OpenSprinkler/OSBeeWiFi-Hardware/README.md

## OpenSprinkler Bee WiFi Eagle Files

This folder contains EagleCAD schematic and board design files for OpenSprinkler Bee WiFi circuit. Please use EagleCAD 7.0 or above to view the files. We generally do not provide BOM, but you can use EagleCAD's BOM script to export a BOM yourself.
