OpenSprinkler/OSBeeWiFi-Hardware/v2.0/README.md

OpenSprinkler Bee 2.0 Pin Assignments:
===================

- GPIO0:  Button
- GPIO2:  COM 
- GPIO4:  SDA
- GPIO5:  SCL
- GPIO12: Z1
- GPIO13: Z2
- GPIO14: Z3
- GPIO15: BST Power  (High-side Switch 1)
- GPIO16: BST Enable (High-side Switch 2)
