OpenSprinkler/OSBeeWiFi-Hardware/v3.0/osbee_3.0.png

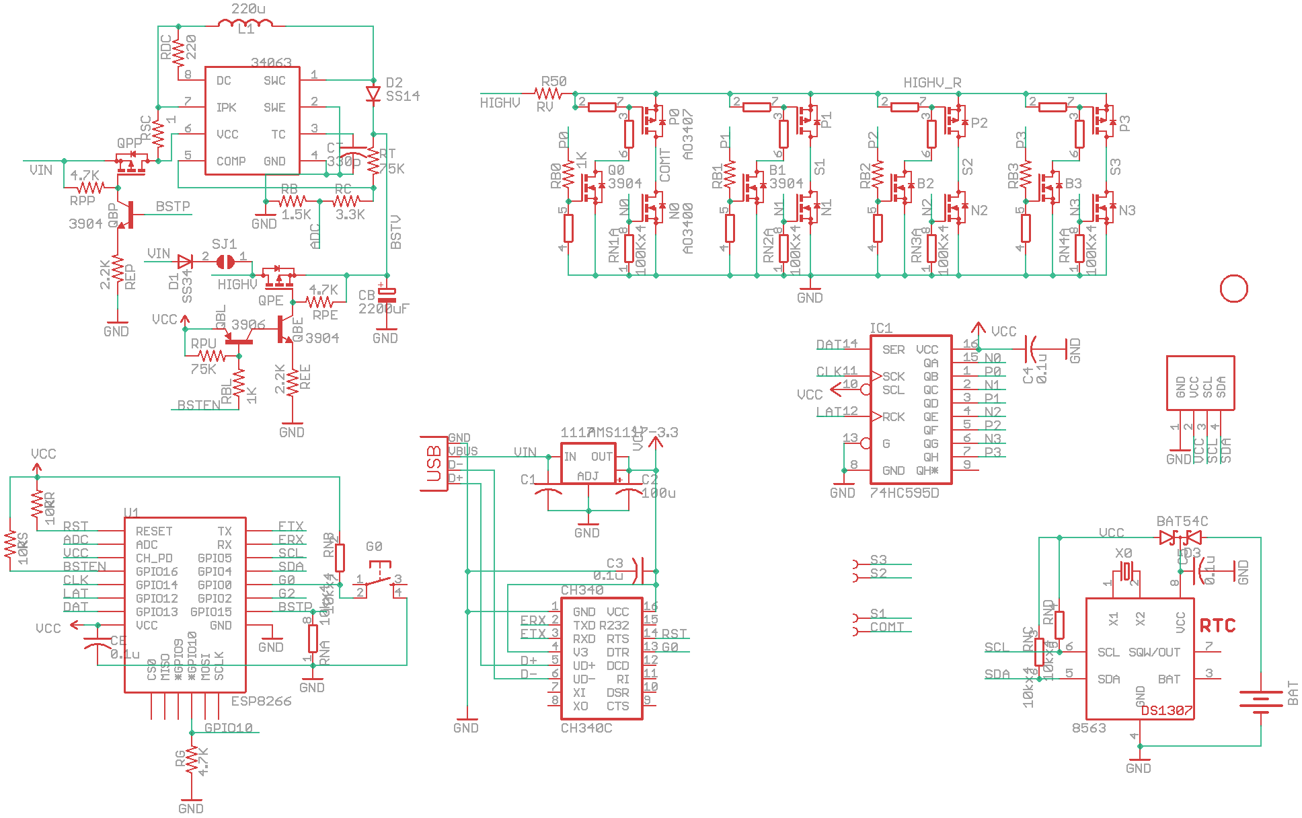
v3.0/osbee_3.0.png
