OpenSprinkler/OSBeeWiFi-Hardware/v3.0/OSBee3_enclosure.stl

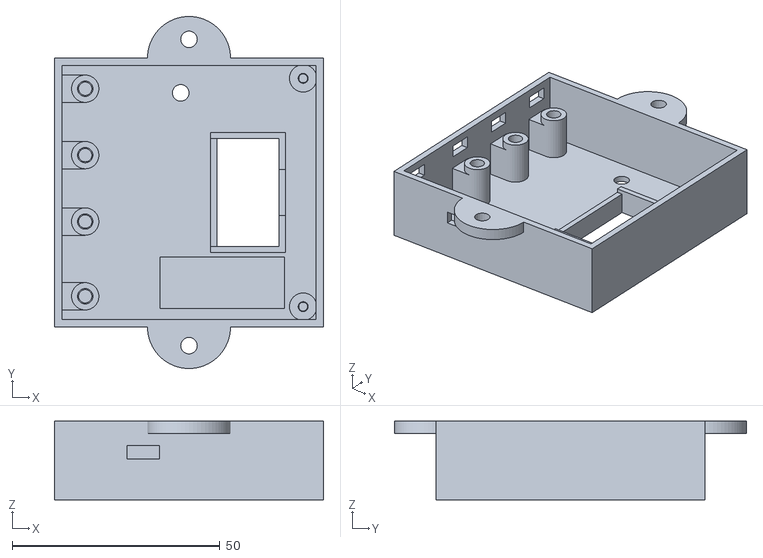
[picture p2: CAD file, 2023-06-05]
v3.0/OSBee3_enclosure.stl
64.8 x 84.8 x 19.0
