OpenSprinkler/OSBeeWiFi-Hardware/v3.0/osbee_3.0.brd

## EAGLE design v3.0/osbee_3.0.brd (2021-09-07)

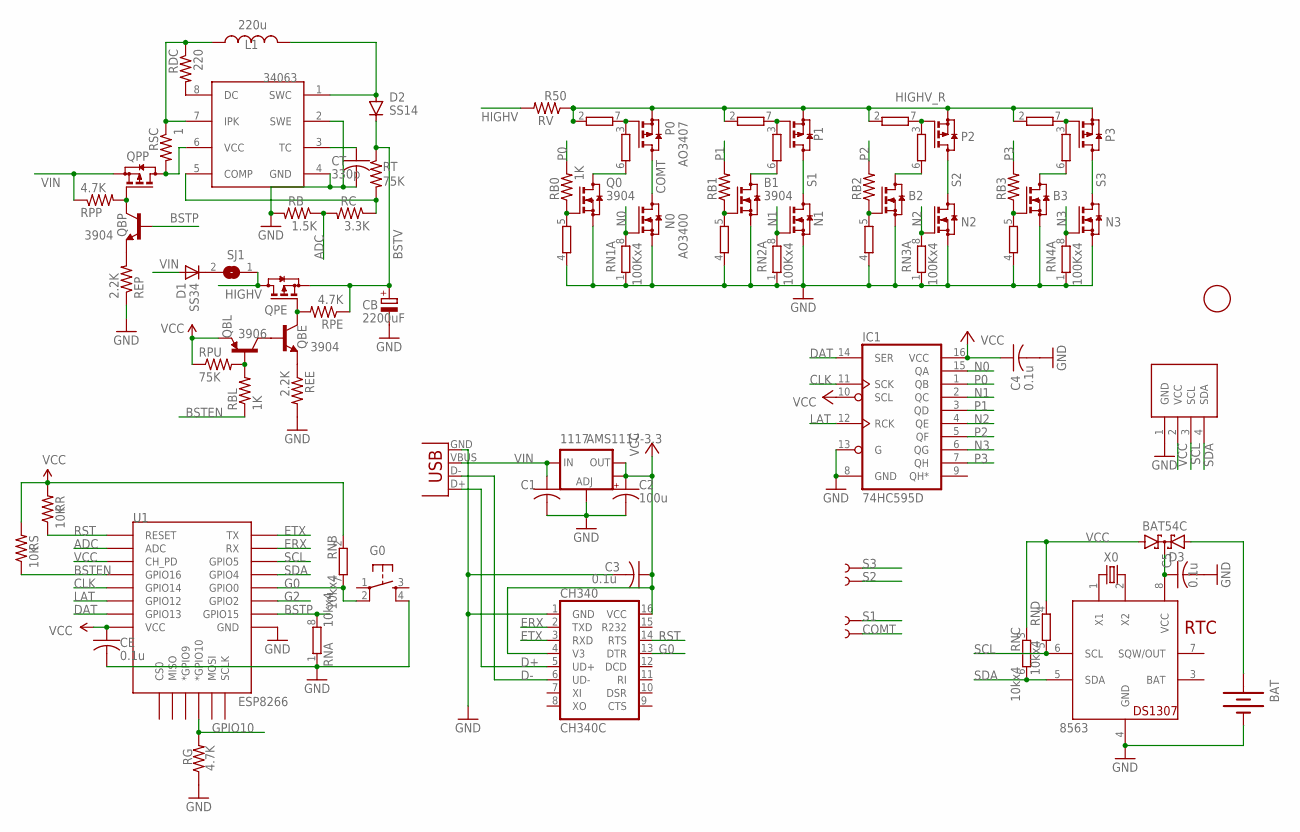
[picture p3: schematic osbee_3.0.sch]

Parts:
1F: FIDUCIAL; FIDUCIAL_1MM
1117: AMS1117-3.3; SOT223
8563: PCF8563; SO08
34063: MC34063; SO08
B1, B2, B3: 3904; SOT23
BAT: BATTERYBATTERY_12MM_SMT; BATTCON_12MM_SMT
C1: 10u; C0805K
C2: 100u; PANASONIC_C
C3: 0.1u; C0603K
C4, C5: 0.1u; C0603
CB: 2200uF; E5-8,5
CE: 0.1u; C0603
CH340: CH340C; SO16
CT: 330p; C0603K
D1: SS34; SMB-DIODE
D2: SS14; DO-214AC
D3: BAT54C; SOT23
G0: SPST_TACT; EVQ-Q2-SMD
IC1: 74HC595D; SO16
L1: 220u; CR54
N0, N1, N2, N3: AO3400; SOT23
P0, P1, P2, P3: AO3407; SOT23
Q0: 3904; SOT23
QBE: 3904; SOT23-3
QBL: 3906; SOT23-3
QBP: 3904; SOT23-3
QPE: AO3407; SOT23
QPP: AO3407; SOT23
RB: 1.5K; R0603
RB0, RB1, RB2, RB3: 1K; R0603
RBL: 1K; R0603
RC: 3.3K; R0603
RDC: 220; R0603
REE: 2.2K; R0603
REP: 2.2K; R0603
RG: 4.7K; R0603
RN: 10kx4; EXB38V
RN1, RN2, RN3, RN4: 100Kx4; EXB38V
RPE: 4.7K; R0603
RPP: 4.7K; R0603
RPU: 75K; R0603
RR: 10K; R0603
RS: 10K; R0603
RSC: 1; R0603
RT: 75K; R0603
RV: R50; R2512
SJ1: SJ
ST1, ST2, ST3: NOBOM-; PETAL-9X9
STT: NOBOM-; PETAL-9X9
U1: ESP8266; ESP12E-SMD
U$1: NOBOM-OLED; SSD1306_OLED_I2C_PCB_0.75_BNEW
USB: USBMICROB2; USB-MICROB2
X0: 32.768kHz; 3.2X1.5

Connections:
ADC: RB.1, RC.2, U1.ADC
BAT: 8563.3 (BAT)
BSTEN: RBL.1, RS.1, U1.GPIO16
BSTP: QBP.1 (B), RN.8 (2), U1.GPIO15
BSTV: CB.+, D2.C, QPE.2 (S), RPE.1, RT.1
CLK: IC1.11 (SCK), U1.GPIO14
COMT: N0.3 (D), P0.3 (D), STT.P$1
D+: CH340.5 (UD+), USB.D+
D-: CH340.6 (UD-), USB.D-
DAT: IC1.14 (SER), U1.GPIO13
ERX: CH340.2 (TXD), U1.RXD0 (RX)
ETX: CH340.3 (RXD), U1.TXD0 (TX)
G0: CH340.13 (DTR), G0.2, RN.7 (2), U1.GPIO0
G2: U1.GPIO2
GND: 1117.1 (ADJ), 8563.4 (GND), 34063.2 (SWE), 34063.4 (GND), B1.2 (S), B2.2 (S), B3.2 (S), BAT.P$1 (-), C1.2, C2.-, C3.2, C4.2, C5.2, CB.-, CE.2, CH340.1 (GND), CT.2, G0.4, IC1.8 (GND), IC1.13 (G), N0.2 (S), N1.2 (S), N2.2 (S), N3.2 (S), Q0.2 (S), RB.2, REE.2, REP.1, RG.1, RN.1, RN1.1, RN1.4 (1), RN2.1, RN2.4 (1), RN3.1, RN3.4 (1), RN4.1, RN4.4 (1), U1.GND, U$1.1 (GND), USB.GND
GPIO10: RG.2, U1.GPIO10 (*GPIO10)
HIGHV: QPE.3 (D), RV.2, SJ1.1
HIGHV_R: P0.2 (S), P1.2 (S), P2.2 (S), P3.2 (S), RN1.2 (1), RN2.2 (1), RN3.2 (1), RN4.2 (1), RV.1
LAT: IC1.12 (RCK), U1.GPIO12
N0: IC1.15 (QA), N0.1 (G), RN1.8 (2)
N1: IC1.2 (QC), N1.1 (G), RN2.8 (2)
N2: IC1.4 (QE), N2.1 (G), RN3.8 (2)
N3: IC1.6 (QG), N3.1 (G), RN4.8 (2)
unnamed: P0.1 (G), RN1.3 (1), RN1.7 (2)
unnamed: QBP.3 (C), QPP.1 (G), RPP.2
unnamed: Q0.3 (D), RN1.6 (2)
unnamed: B1.3 (D), RN2.6 (2)
unnamed: Q0.1 (G), RB0.1, RN1.5 (2)
unnamed: B3.1 (G), RB3.1, RN4.5 (2)
unnamed: P1.1 (G), RN2.3 (1), RN2.7 (2)
unnamed: B3.3 (D), RN4.6 (2)
unnamed: 34063.1 (SWC), D2.A, L1.P$2 (2)
unnamed: D1.C, SJ1.2
unnamed: BAT.P$2 (+), D3.2 (A2)
unnamed: P2.1 (G), RN3.3 (1), RN3.7 (2)
unnamed: B2.3 (D), RN3.6 (2)
unnamed: 8563.1 (X1), X0.1
unnamed: QBL.1 (B), RBL.2, RPU.2
unnamed: P3.1 (G), RN4.3 (1), RN4.7 (2)
unnamed: QBE.1 (B), QBL.3 (C)
unnamed: QBE.2 (E), REE.1
unnamed: B1.1 (G), RB1.1, RN2.5 (2)
unnamed: B2.1 (G), RB2.1, RN3.5 (2)
unnamed: 34063.7 (IPK), L1.P$1 (1), RDC.1, RSC.1
unnamed: 34063.6 (VCC), QPP.3 (D), RSC.2
unnamed: 34063.3 (TC), CT.1
unnamed: 34063.5 (COMP), RC.1, RT.2
unnamed: 8563.2 (X2), X0.2
unnamed: 34063.8 (DC), RDC.2
unnamed: QBP.2 (E), REP.2
unnamed: QBE.3 (C), QPE.1 (G), RPE.2
unnamed: 8563.8 (VCC), C5.1, D3.3 (CC)
P0: IC1.1 (QB), RB0.2
P1: IC1.3 (QD), RB1.2
P2: IC1.5 (QF), RB2.2
P3: IC1.7 (QH), RB3.2
RST: CH340.14 (RTS), RR.1, U1.RESET
S1: N1.3 (D), P1.3 (D), ST1.P$1
S2: N2.3 (D), P2.3 (D), ST2.P$1
S3: N3.3 (D), P3.3 (D), ST3.P$1
SCL: 8563.6 (SCL), RN.5 (2), U1.GPIO5, U$1.3 (SCL)
SDA: 8563.5 (SDA), RN.6 (2), U1.GPIO4, U$1.4 (SDA)
VCC: 1117.2 (OUT), 1117.4 (OUT), C2.+, C3.1, C4.1, CE.1, CH340.4 (V3), CH340.16 (VCC), D3.1 (A1), IC1.10 (SCL), IC1.16 (VCC), QBL.2 (E), RN.2 (1), RN.3 (1), RN.4 (1), RPU.1, RR.2, RS.2, U1.CH_PD, U1.VCC, U$1.2 (VCC)
VIN: 1117.3 (IN), C1.1, D1.A, QPP.2 (S), RPP.1, USB.VBUS

Notes on the sheet:
RTC

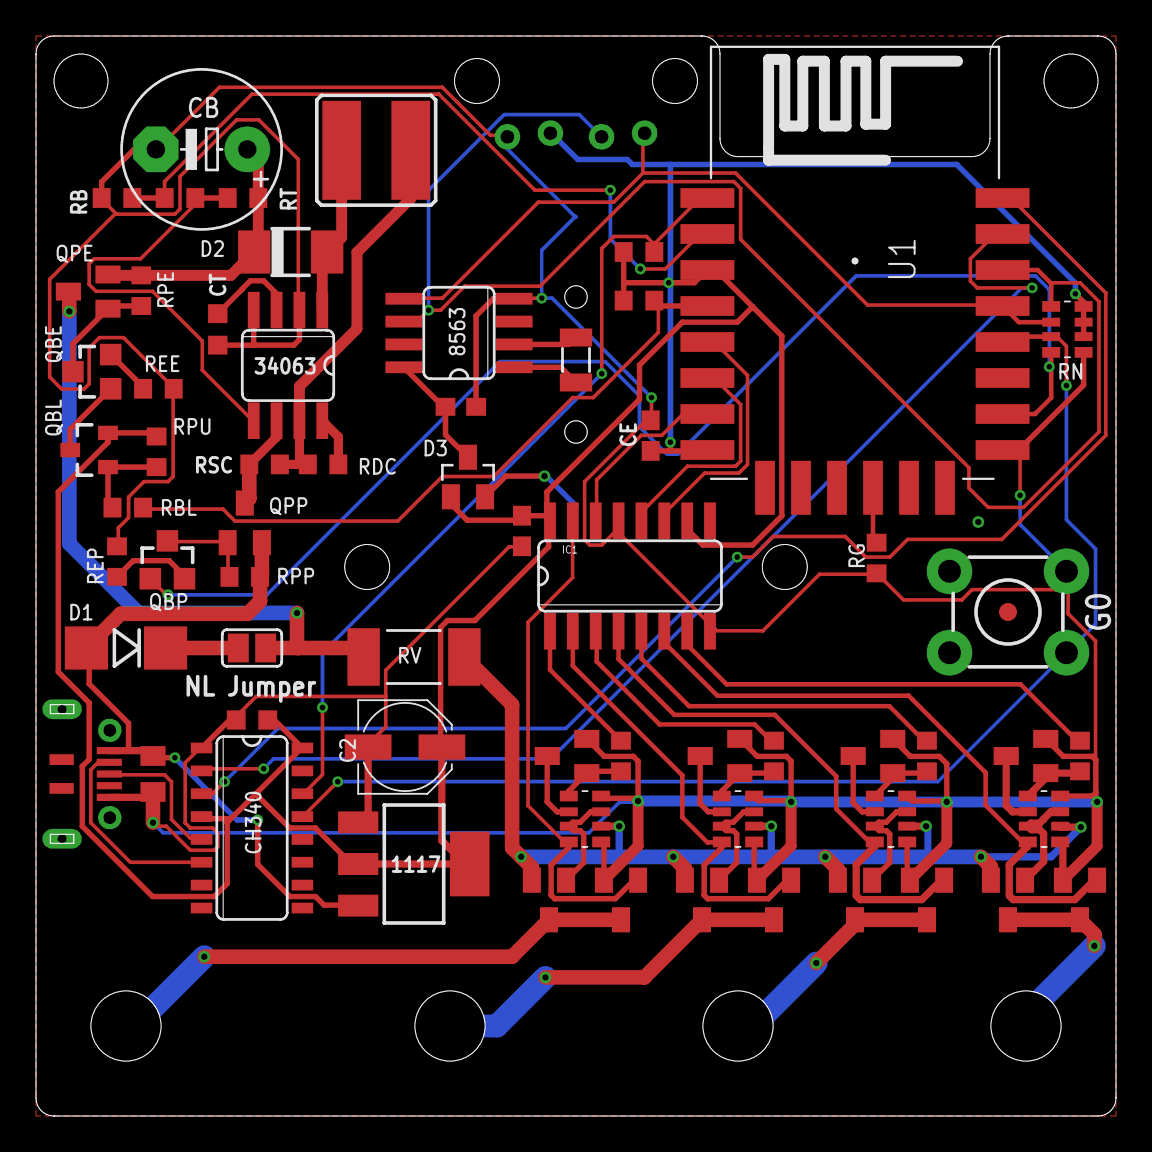
[picture p4: board osbee_3.0.brd from above]

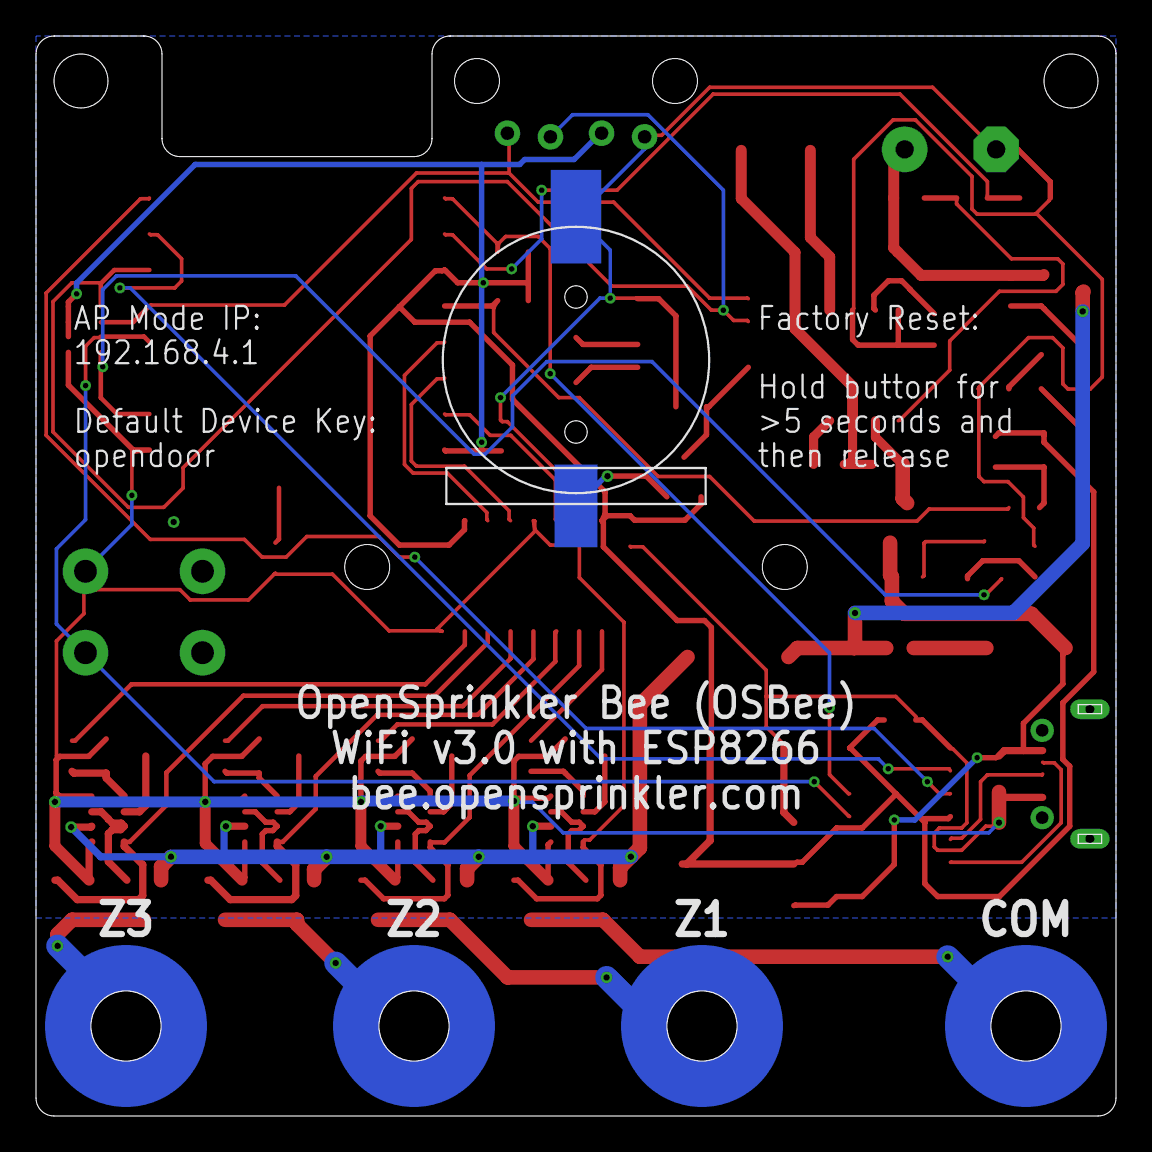
[picture p5: board osbee_3.0.brd from below]

Board: 2 copper layers, 60.0 x 60.0 mm, 70 parts (5 on the bottom side), 62 nets.
