OpenSprinkler/OSBeeWiFi-Hardware/v2.0/osbwifi20.brd

## EAGLE design v2.0/osbwifi20.brd (2016-12-05, an earlier design)

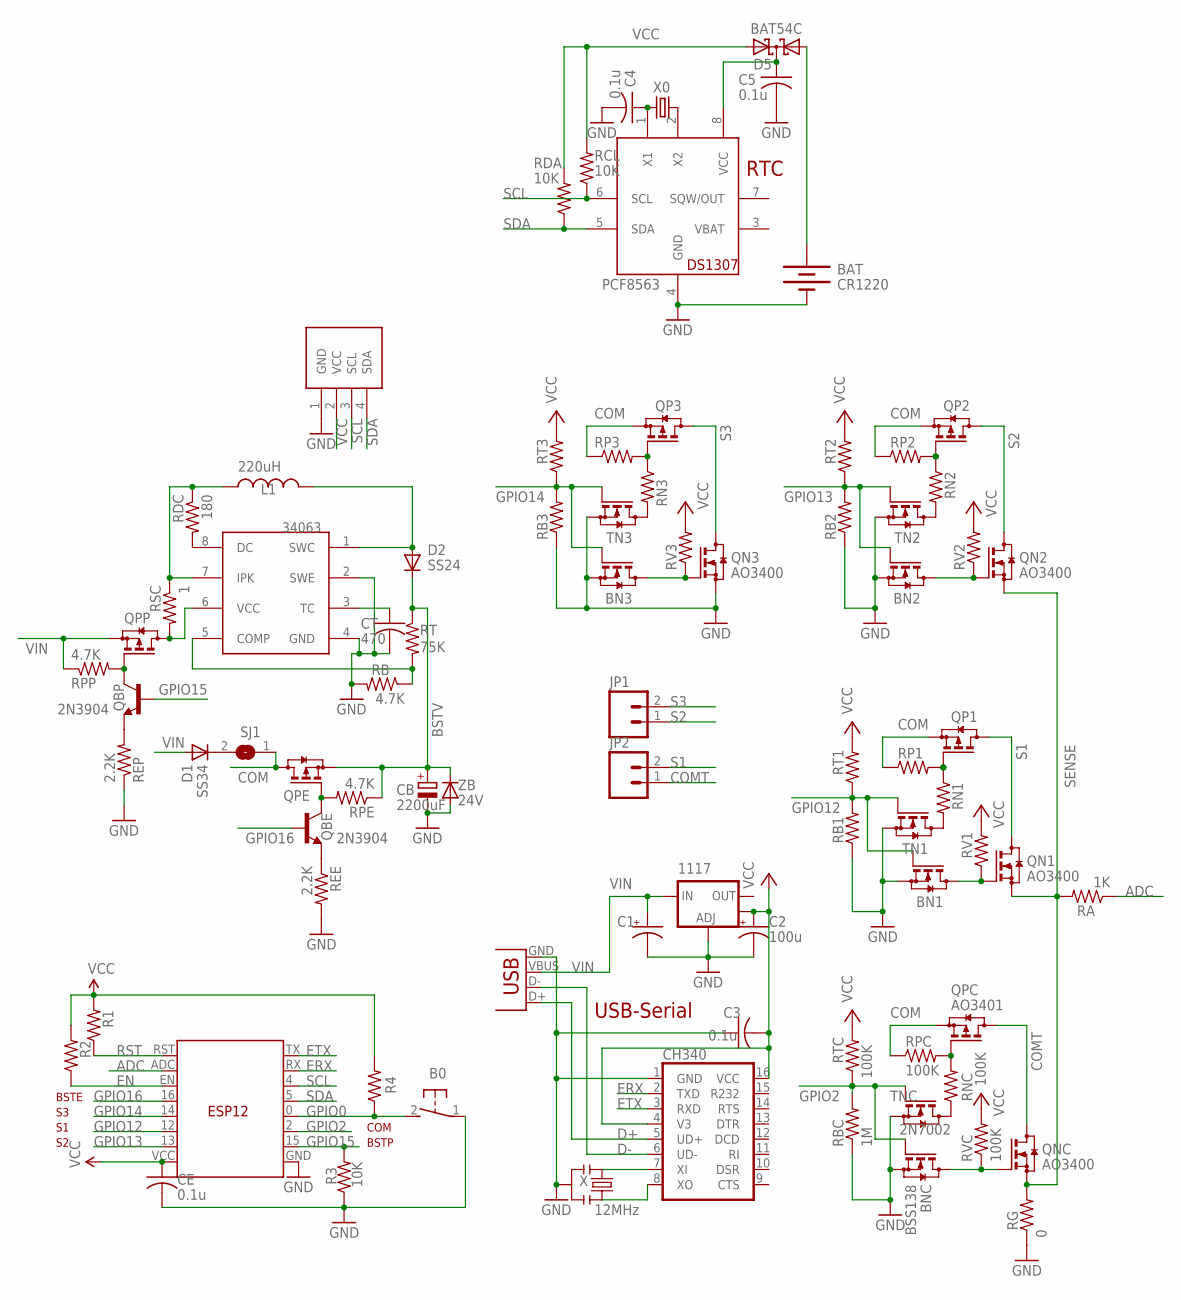
[picture p6: schematic osbwifi20.sch]

Parts:
1117: 1117; SOT223
34063: MC33063/MC34063D; SO08
B0: 31-XX; B3F-31XX
BAT: CR1220; BATTCON_12MM_SMT
BN1, BN2, BN3: BSS138; SOT23
BNC: BSS138; SOT23
C1, C2: 100u; B/3528-21R
C3, C4, C5: 0.1u; C0603
CB: 2200uF; E5-8,5
CE: 0.1u; C0603
CH340: CH340G; SO16
CT: 470; C0603K
D1: SS34; SMB
D2: SS24; DO-214AC
D5: BAT54C; SOT23
ESP: ESP; ESP12
JP1, JP2: M025MM; SCREWTERMINAL-5MM-2
L1: 220uH; CR54
PCF8563: PCF8563; SO08
QBE: 2N3904; SOT23-3
QBP: 2N3904; SOT23-3
QN1, QN2, QN3: AO3400; SOT23
QNC: AO3400; SOT23
QP1, QP2, QP3: AO3407; SOT23
QPC: AO3401; SOT23
QPE: AO3401; SOT23
QPP: AO3401; SOT23
R1, R2, R3, R4: 10K; R0603
RA: 1K; R0603
RB: 4.7K; R0603
RB1, RB2, RB3: 1M; R0603
RBC: 1M; R0603
RCL: 10K; R0603
RDA: 10K; R0603
RDC: 180; R0603
REE: 2.2K; R0603
REP: 2.2K; R0603
RG: 0; R2512
RN1, RN2, RN3: 100K; R0603
RNC: 100K; R0603
RP1, RP2, RP3: 100K; R0603
RPC: 100K; R0603
RPE: 4.7K; R0603
RPP: 4.7K; R0603
RSC: 1; R0603
RT: 75K; R0603
RT1, RT2, RT3: 100K; R0603
RTC: 100K; R0603
RV1, RV2, RV3: 100K; R0603
RVC: 100K; R0603
SJ1: SJ
TN1, TN2, TN3: 7002; SOT23
TNC: 2N7002; SOT23
U$1: SSD1306_OLED_I2C
USB: USBSMD; USB-MINIB
X: 12MHz; RESONATOR-SMD
X0: 32.768kHz; MM20SS1
ZB: 24V; MINIMELF

Connections:
ADC: ESP.ADC, RA.1
BSTV: CB.+, D2.C, QPE.2 (S), RPE.1, RT.1, ZB.C
COM: QP1.2 (S), QP2.2 (S), QP3.2 (S), QPC.2 (S), QPE.3 (D), RP1.1, RP2.1, RP3.1, RPC.1, SJ1.1
COMT: JP2.1, QNC.3 (D), QPC.3 (D)
D+: CH340.5 (UD+), USB.D+
D-: CH340.6 (UD-), USB.D-
EN: ESP.EN, R2.1
ERX: CH340.2 (TXD), ESP.RX
ETX: CH340.3 (RXD), ESP.TX
GND: 1117.1 (ADJ), 34063.2 (SWE), 34063.4 (GND), B0.1, BAT.P$1 (-), BN1.2 (S), BN2.2 (S), BN3.2 (S), BNC.2 (S), C1.-, C2.-, C3.1, C4.2, C5.2, CB.-, CE.2, CH340.1 (GND), CT.2, ESP.GND, PCF8563.4 (GND), QN3.2 (S), R3.1, RB.2, RB1.1, RB2.1, RB3.1, RBC.1, REE.2, REP.1, RG.1, TN1.2 (S), TN2.2 (S), TN3.2 (S), TNC.2 (S), U$1.1 (GND), USB.GND, X.2, ZB.A
GPIO0: B0.2 (S), ESP.0 (G0), R4.1
GPIO2: BNC.1 (G), ESP.2 (G2), RBC.2, RTC.1, TNC.1 (G)
GPIO12: BN1.1 (G), ESP.12 (G12), RB1.2, RT1.1, TN1.1 (G)
GPIO13: BN2.1 (G), ESP.13 (G13), RB2.2, RT2.1, TN2.1 (G)
GPIO14: BN3.1 (G), ESP.14 (G14), RB3.2, RT3.1, TN3.1 (G)
GPIO15: ESP.15 (G15), QBP.1 (B), R3.2
GPIO16: ESP.16 (G16), QBE.1 (B)
unnamed: QPC.1 (G), RNC.2, RPC.2
unnamed: QBP.3 (C), QPP.1 (G), RPP.2
unnamed: RNC.1, TNC.3 (D)
unnamed: RN1.2, TN1.3 (D)
unnamed: BNC.3 (D), QNC.1 (G), RVC.1
unnamed: CH340.7 (XI), X.1
unnamed: QP1.1 (G), RN1.1, RP1.2
unnamed: RN3.2, TN3.3 (D)
unnamed: 34063.1 (SWC), D2.A, L1.P$2 (2)
unnamed: D1.C, SJ1.2
unnamed: BN1.3 (D), QN1.1 (G), RV1.1
unnamed: QP2.1 (G), RN2.1, RP2.2
unnamed: RN2.2, TN2.3 (D)
unnamed: C4.1, PCF8563.1 (X1), X0.1
unnamed: BN2.3 (D), QN2.1 (G), RV2.1
unnamed: QP3.1 (G), RN3.1, RP3.2
unnamed: BAT.P$2 (+), D5.1 (A1)
unnamed: BN3.3 (D), QN3.1 (G), RV3.1
unnamed: QBE.2 (E), REE.1
unnamed: 34063.7 (IPK), L1.P$1 (1), RDC.1, RSC.1
unnamed: 34063.6 (VCC), QPP.3 (D), RSC.2
unnamed: 34063.3 (TC), CT.1
unnamed: 34063.5 (COMP), RB.1, RT.2
unnamed: PCF8563.2 (X2), X0.4 (2)
unnamed: 34063.8 (DC), RDC.2
unnamed: QBP.2 (E), REP.2
unnamed: QBE.3 (C), QPE.1 (G), RPE.2
unnamed: CH340.8 (XO), X.3
unnamed: C5.1, D5.3 (CC), PCF8563.8 (VCC)
RST: ESP.RST, R1.1
S1: JP2.2, QN1.3 (D), QP1.3 (D)
S2: JP1.1, QN2.3 (D), QP2.3 (D)
S3: JP1.2, QN3.3 (D), QP3.3 (D)
SCL: ESP.4 (G4), PCF8563.6 (SCL), RCL.1, U$1.3 (SCL)
SDA: ESP.5 (G5), PCF8563.5 (SDA), RDA.1, U$1.4 (SDA)
SENSE: QN1.2 (S), QN2.2 (S), QNC.2 (S), RA.2, RG.2
VBAT: PCF8563.3 (VBAT)
VCC: 1117.4 (OUT), C2.+, C3.2, CE.1, CH340.4 (V3), CH340.16 (VCC), D5.2 (A2), ESP.VCC, R1.2, R2.2, R4.2, RCL.2, RDA.2, RT1.2, RT2.2, RT3.2, RTC.2, RV1.2, RV2.2, RV3.2, RVC.2, U$1.2 (VCC)
VIN: 1117.3 (IN), C1.+, D1.A, QPP.2 (S), RPP.1, USB.VBUS

Notes on the sheet:
USB-Serial
BSTP
BSTE
RTC
COM

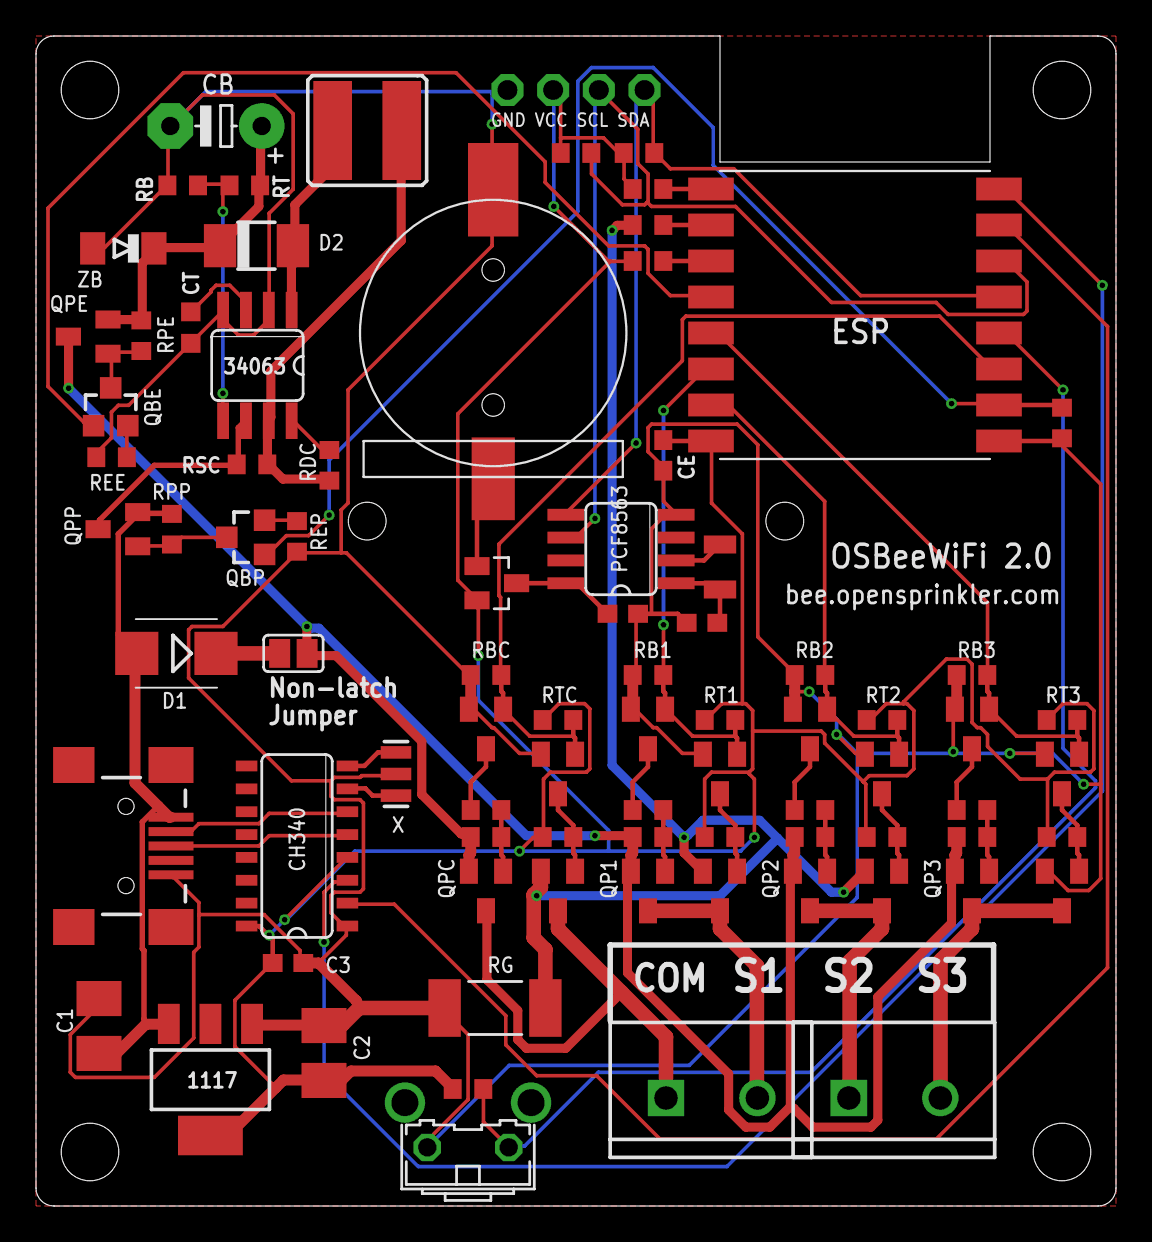
[picture p7: board osbwifi20.brd from above]

Board: 2 copper layers, 60.0 x 65.0 mm, 83 parts (0 on the bottom side), 55 nets.
