OpenSprinkler/OSBeeWiFi-Hardware/(threads)

Thread 1 (2023-08-05):

PCB problems

sergiocro, 2023-08-05:
Hi ...

first of all great work, tahnk you for made it open source ...

I have discovered some errors in PCB design ... can you please check that osbee_3.0.brd and osbee_3.0.sch are ok ...

thank you

sergiocro, 2023-08-05:
[img1](https://ibb.co/59vbxKM)
[img2](https://ibb.co/XVg4TxZl)

sergiocro, 2024-04-16:
so there is no chance to get updated PCB ?

rayshobby, 2024-06-02:
The first image is not a mistake: it's thermo-isolation of a ground pin. The second image, I don't know how you generated this, or which version of EagleCAD you were using, but this is NOT in the OSBee circuit. I attached what shows up in my EagleCAD.
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

sergiocro, 2024-06-02:
Im using autodesk fusion ... first image is showing that GPIO0 is conected to GND ? same thing like on second image where D+ is conecded to GND ... can you plese check that you have same file like on Github. thanks

sergiocro, 2024-06-02:
and this are imgs from pcbway from original osbee_3_2023-05-27 GREB file

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

Closed 2024-06-02.

Thread 2 (2023-08-13):

flash/boot issue

sergiocro, 2023-08-13:
Atrer flashing with OSBee firmware board wont boot ?! every other firmware (esphome or what ever) works fine ?! any sugestion ?

sergiocro, 2023-09-29:
Just cannot find error, esp is flashed and running ok until instaled on board, after instalation it wont bring up correct AP (insted of OSBxxx it is ESPxxxx)

if i try to flash it over usb on board it wont flash ok, AP is ESPxxxx even if chip is removed form board..

Please help

Thank you

rayshobby, 2024-06-02:
After flashing what with OSBee firmware? The OSBee board? Or some other board?

sergiocro, 2024-06-02:
yes the OSBee board wont boot correct
