OpenSprinkler/OSBeeWiFi-Hardware/(commit log)

2016-12-05 check in initial version of OSBeeWiFi Eagle files
    [osbwifi20.brd, osbwifi20.sch]
2016-12-11 add pin assignments
2021-09-07 add v3.0 hardware design files
    [osbee_3.0.brd, osbee_3.0.sch, osbee_3.0_BOM.csv]
2023-06-05 add enclosure 3d print file for osbee3
    [OSBee3_enclosure.stl]
