OpenSprinkler/OSBeeWiFi-Hardware/(notices)

Notices in the files:
parts and their libraries:
crystal-geyer_V1_0: Copyright: Geyer-Electronic
